Bryce-W-Frazier/rc_over_http/hardware/car.scad

// bearingtest.scad
// Body of the car and it's conponets
// units in mm
// Bryce W. Frazier
// Started: 2026-02-06
// Updated: 2026-02-07

// 606 Bearing
bearing_d = 17;
inner_bearing_d = 6;
bearing_w = 6;

rear_mount_thic = 3;
rear_mount_d = bearing_d+rear_mount_thic;

// Wheel Specs
wheel_d = 35;
wheel_w = 10;
axle_insert = 5;
rim = 3;

// Motor Specs
motor_l = 47;
motor_d = 28;

motor_mount_w = motor_d+2;
motor_strap_w = 13;
motor_strap_gap = 2;

// Steering
steer_bearing_dis = 3;
steer_pin_d = 4;

hub_l = 11.5;
front_axle_stop = 2;
front_axle_l = front_axle_stop+hub_l+1+axle_insert;


// Body Specs
body_w = 80;
body_l = 175;
body_thic = 4;
axel_access = 12;
wheel_lift = 2;

wheel_depth = wheel_lift+rear_mount_d/2;

// PCB Footprint
L298N_hole_dis = 37;
L298N_body_l = 43;

rasbpiB_hole_w_dis = 49;
rasbpiB_hole_l_dis = 58;
rasbpiB_body_w = 56;
rasbpiB_body_l = 85;
rasbpi_screw = 2.5 -2;

pcb_clear = 4;

// Wheels and Axles
module axle(l, d) {
    difference() {
        cylinder(h=l, d=d);
        
        translate([-(d*3)/4, 0, l/2])
            cube([d, d, l], center=true);
    }
}

module frontAxle() {
    translate([-front_axle_l, 0, 0])
    rotate([0, 90, 0]) {
        axle(front_axle_l, inner_bearing_d);
        difference() {
            axle(front_axle_stop, inner_bearing_d+1);
            translate([-inner_bearing_d/2+.5, -inner_bearing_d/2-.5, 0])
                cube([1, inner_bearing_d+1, front_axle_stop]); 
        }
        
    }
}

module wheel() {
    translate([0, 0, wheel_w])
    rotate([180, 0, 0])
    difference() {
        cylinder(h=wheel_w, d=wheel_d);
        cylinder(h=wheel_w-axle_insert, d=wheel_d-rim);
        translate([0, 0, wheel_w-axle_insert])
            axle(axle_insert, inner_bearing_d+1);
    };
}

// Drivetrain
module rearBearingMount() { 
    translate([0, rear_mount_d, -wheel_lift-rear_mount_d/2])
    rotate([90, 0, 90]) {
        difference() {
            union() {
                cylinder(h=bearing_w, d = rear_mount_d);
                
                translate([0, rear_mount_d/2, 0])
                    cylinder(h=bearing_w, d =rear_mount_d*2);
           }
           translate([0, rear_mount_d, bearing_w/2])
                    cube([rear_mount_d*2, rear_mount_d, bearing_w], center=true); 
           cylinder(h=bearing_w, d=bearing_d);
        }
        translate([0, (rear_mount_d + wheel_lift)/2, bearing_w/2])
            cube([rear_mount_d*2, wheel_lift, bearing_w], center=true);
    }
}

module motorMount() {
    translate([0, motor_mount_w/2, motor_mount_w/2])
    rotate([90, 0, 90])
    difference() {
        translate([0, -motor_mount_w/4, motor_l/2])
            cube([motor_mount_w, motor_mount_w/2, motor_l], center=true);
        cylinder(h=motor_l, d=motor_d);
    };
}

module pully(belt_thic, di) {
    wall_thic = 1;
    shell_h = belt_thic+wall_thic*2;
    resses = belt_thic;
    
    difference() {
        cylinder(h=shell_h, d=belt_thic+di);
        translate([0, 0, wall_thic])
        difference() {
            cylinder(h=belt_thic, d=belt_thic+di);
            cylinder(h=belt_thic, d=di);
        }
        
    }
}

module motorPully(){
    difference() {
        pully(3, 30);
        cylinder(5, 2);
    }
}

module axlePully(){
    difference() {
        pully(3, 10);
        axle(5, inner_bearing_d+0.5);
    }
}
// Steering
module steeringWheelMount() {
    dist_from_body = rear_mount_d/2 + wheel_lift;
    
    rod_to_frnt_l = 20;
    
    // Pivot Rod
    difference() {
        union(){
            difference() {
                cylinder(h=body_thic+8, d=inner_bearing_d-1);
                
                translate([0, 0, body_thic+5]) {
                    rotate([0, 90, 0])
                        cylinder(h=inner_bearing_d, d=2);
                    rotate([0, -90, 0])
                        cylinder(h=inner_bearing_d, d=2);
                }
            }    
            translate([0, 0, -dist_from_body]) {
                cylinder(h=dist_from_body, d=inner_bearing_d+1); // Also pivot rod
                
                // Bearing Hub
                rotate([0,-90,0])
                difference() {
                    union() {
                        cylinder(h=hub_l, d=rear_mount_d);
                        translate([0, 0, -inner_bearing_d/2-0.5])
                            cylinder(h=inner_bearing_d+1, d=rear_mount_d);
                    }
                    translate([0, 0, hub_l-bearing_w]) {
                        cylinder(h=bearing_w, d=bearing_d);
                    }
                };
                
                // Secondary Tie Rod
                rotate([-90,0,0])
                    cylinder(h=rod_to_frnt_l, d=6);
                translate([0,rod_to_frnt_l,0]) {
                    sphere(d=6);
                    cylinder(h=10, d=steer_pin_d);
                }
            }
        }
        // Axle Access
        translate([0, 0, -dist_from_body])
        rotate([0, 90,0])
        translate([0, 0, -(hub_l-bearing_w)])
            cylinder(h=rod_to_frnt_l, d=(bearing_d+inner_bearing_d)/2);
    }
}

module priTieRod() {
    hole_d = steer_pin_d+1;
    hole_spaceing = steer_pin_d+2;
    rod_l = body_w-rear_mount_d+steer_pin_d+steer_bearing_dis/2;
    
    rotate([0, -90, 0])
    difference() {
        axle(rod_l, hole_spaceing);
        rotate([0, 90, 0]) {
            translate([-(steer_pin_d/2+2), 0, -inner_bearing_d/2])
                cylinder(h=inner_bearing_d, d=hole_d);
            translate([-rod_l+(steer_pin_d/2+2), 0, -inner_bearing_d/2])
                cylinder(h=inner_bearing_d, d=hole_d);
        }
    }
}

//PCB Footprint
module screwMount(s_h, s_d) {
    difference() {
        cylinder(h=s_h, d=s_d+1.5);
        cylinder(h=s_h, d=s_d);
    }
}
module rasbpi() {
   screwMount(pcb_clear, rasbpi_screw);
   translate([rasbpiB_hole_w_dis, 0, 0])
        screwMount(pcb_clear, rasbpi_screw);
   translate([0, rasbpiB_hole_l_dis, 0]) {
        screwMount(pcb_clear, rasbpi_screw);
        translate([rasbpiB_hole_w_dis, 0, 0])
            screwMount(pcb_clear, rasbpi_screw);
    }
}

module L298N() {
    screwMount(pcb_clear, rasbpi_screw);
   translate([L298N_hole_dis, 0, 0])
        screwMount(pcb_clear, rasbpi_screw);
   translate([0, L298N_hole_dis, 0]) {
        screwMount(pcb_clear, rasbpi_screw);
        translate([L298N_hole_dis, 0, 0])
            screwMount(pcb_clear, rasbpi_screw);
    }
}
// Overall Car
module steeringMountAndWheel() {
    steeringWheelMount();
    
    rotate([0, 0, 180])
    translate([(hub_l-bearing_w+front_axle_l-front_axle_stop), 0, -wheel_lift-rear_mount_d/2])
        frontAxle();
    
    rotate([0, -90, 0])
    translate([-wheel_depth, 0, hub_l+1])
    rotate([0, 0, 180])
        wheel();
}
module mainBody() {
    // Servo Specs 
    // Tower Pro SG90
    servo_w       = 23;
    servo_tab     =  5;
    servo_h       = 12;
    servo_mount_l = 15;
    servo_mount_screw = 2;
    
    //Steering clearance
    steering_cutout_angle = 50;

    difference(){
        union() {
            cube([body_w, body_l, body_thic], center=false);
            
    // Drive Train ################################################
            // Axle Mount
            rearBearingMount();
            translate([body_w - bearing_w, 0, 0]) rearBearingMount();
        }
    // Access of Axle for Beltdrive
    translate([bearing_w, rear_mount_d/4, 0]) 
        cube([axel_access, (rear_mount_d*3)/2, body_thic]);
    
    // Motor Straps
    translate(
    [bearing_w + axel_access + motor_l/8, rear_mount_d/4 - motor_strap_gap, 0])
        cube([motor_strap_w, motor_strap_gap, body_thic]);    
    translate(
    [bearing_w + axel_access + 7*motor_l/8, rear_mount_d/4 - motor_strap_gap, 0])
        cube([motor_strap_w, motor_strap_gap, body_thic]);   
    translate(
    [bearing_w + axel_access + motor_l/8, rear_mount_d/4 + (rear_mount_d*3)/2, 0])
        cube([motor_strap_w, motor_strap_gap, body_thic]);    
    translate(
    [bearing_w + axel_access + 7*motor_l/8, rear_mount_d/4 + (rear_mount_d*3)/2, 0])
        cube([motor_strap_w, motor_strap_gap, body_thic]); 
        
    // Steering ###################################################
    // Body cutout of steering clearance
    translate(
    [bearing_d/4+steer_bearing_dis, 
    body_l - bearing_d/2-steer_bearing_dis, 
    0])
        cube(
        [rear_mount_d/2+steer_bearing_dis*2, 
        rear_mount_d+steer_bearing_dis, 
        body_thic*2], 
        center=true);
    translate([body_w-(bearing_d/4+steer_bearing_dis), 
    (body_l - bearing_d/2-steer_bearing_dis), 
    0])
        cube(
        [rear_mount_d/2+steer_bearing_dis*2, 
        rear_mount_d+steer_bearing_dis, 
        body_thic*2], 
        center=true);
    
    translate([rear_mount_d, body_l -rear_mount_d-steer_bearing_dis, 0])
    rotate([0, 0, 90+steering_cutout_angle])
        cube([body_l, body_l, body_thic]);
    translate([body_w-rear_mount_d, body_l -rear_mount_d-steer_bearing_dis, 0])
    rotate([0, 0, -steering_cutout_angle])
        cube([body_l, body_l, body_thic]);


    // Bearing Holes
    translate([bearing_d/2+steer_bearing_dis, body_l - bearing_d/2-steer_bearing_dis, 0])
        cylinder(h=bearing_w, d=bearing_d);
    translate([body_w-(bearing_d/2+steer_bearing_dis), body_l - (bearing_d/2+steer_bearing_dis), 0])
        cylinder(h=bearing_w, d=bearing_d);      
    
    } // End of difference()
    
    translate([bearing_d/2+steer_bearing_dis, body_l - (bearing_d/2+steer_bearing_dis), 0])
    difference() {
        cylinder(h=bearing_w, d=bearing_d+3);
        cylinder(h=bearing_w, d=bearing_d);
    };
    translate([body_w-(bearing_d/2+steer_bearing_dis), body_l - (bearing_d/2+steer_bearing_dis), 0])
    difference() {
        cylinder(h=bearing_w, d=bearing_d+3);
        cylinder(h=bearing_w, d=bearing_d);
    };
    
    translate([bearing_d/2+steer_bearing_dis, body_l- bearing_d/2-steer_bearing_dis, bearing_w])
        difference() {
            cylinder(h=2, d=bearing_d+3);
            cylinder(h=2, d=(inner_bearing_d+bearing_d)/2);
        }
    translate([body_w-(bearing_d/2+steer_bearing_dis), body_l- bearing_d/2-steer_bearing_dis, bearing_w])
        difference() {
            cylinder(h=2, d=bearing_d+3);
            cylinder(h=2, d=(inner_bearing_d+bearing_d)/2);
        }
        
    // Servo Mount
    translate([body_w/2, body_l-servo_mount_l/2, servo_h/2+body_thic])
    difference() {
        cube([servo_w+servo_tab*2, servo_mount_l, servo_h], center=true);
        cube([servo_w, servo_mount_l, servo_h], center=true);
        rotate([-90, 0, 0]) {
            translate([(servo_w+servo_tab)/2, 0, -servo_mount_l/2])
                cylinder(h=servo_mount_l*2, d=servo_mount_screw);
            translate([-(servo_w+servo_tab)/2, 0, -servo_mount_l/2])
                cylinder(h=servo_mount_l*2, d=servo_mount_screw);
        }
    }
}

module wholeCar () {
    demo_steer_angle = 0;
    
    mainBody();
    
    // Powertrain
    translate([bearing_w + axel_access + motor_l/8, rear_mount_d/4, body_thic])
        motorMount();
    
    translate([-axle_insert*2-1, rear_mount_d, -wheel_depth])
    rotate([0, 90, 0])
        axle(body_w+axle_insert*4+2, inner_bearing_d);
    translate([-1, rear_mount_d, -wheel_depth])
    rotate([0, -90, 0])
    rotate([0, 0, 180])
        wheel();
    translate([body_w+1, rear_mount_d, -wheel_depth])
    rotate([0, 90, 0])
        wheel();
    
    // Steering
    translate([bearing_d/2+3, body_l- bearing_d/2-3, 0])
    rotate([0, 0, demo_steer_angle])
        steeringMountAndWheel();
    translate([body_w-(bearing_d/2+3), body_l- bearing_d/2-3, 0])
    mirror([1, 0, 0])
    rotate([0, 0, -demo_steer_angle])
        steeringMountAndWheel();
       
    translate(
    [body_w - rear_mount_d/2 + steer_bearing_dis, 
    body_l+8.5, 
    -wheel_depth+inner_bearing_d/2+1])
        priTieRod();
        
    translate(
    [rasbpiB_body_w-rasbpiB_hole_w_dis, 
    rear_mount_d*2+rasbpiB_body_w+1, 
    body_thic])
    rotate([0, 0, -90])
        rasbpi();
}



//wholeCar();

/*
rotate([0, 90, 0])
translate([-inner_bearing_d/2-0.5, 0, 0])
mirror([0, 1, 0])
    steeringWheelMount();
translate([0, 40, 1.5])
rotate([0,180, 0])
    frontAxle();
translate([0, -50, 0])
translate([0, 0, 0])
    wheel();

translate([25, 0, 0])
rotate([0,0,90])
priTieRod();
*/
motorPully();
translate([40, 0, 0])
    axlePully();
translate([0, 40, 0])
    wheel();
translate([0, 80, 0])
    wheel();
translate([-20, 0, 0])
    axle(body_w+axle_insert*4+2, inner_bearing_d);
translate([0, -80, 0])
    motorMount();
