Bryce-W-Frazier/rc_over_http/(commit log)

2026-02-01 Added servo Function
2026-02-01 Impelmented Steering Mockup
2026-02-01 npm: add package socket.io, removed onoff
2026-02-01 socket.io: prof of consept
2026-02-02 Client now uses steering vector
2026-02-02 now goes straight, when no steering input
2026-02-02 Steering improved
2026-02-02 Added throttle
2026-02-08 hardware: Started Car, set up drivetrain
    [car.scad]
2026-02-08 hardware: added steering bearings
    [car.scad]
2026-02-08 hardware: added wholeCar module
    [car.scad]
2026-02-08 hardware: lifted stearing mount bearings
    [car.scad]
2026-02-08 hardare: add wheel lift
    [car.scad]
2026-02-08 hardare: SteeringWheelMount fully implemnted
    [car.scad]
2026-02-08 doc: Improved comments.
    [car.scad]
2026-02-08 hardware: implemented servo mount
    [car.scad]
2026-02-08 fix: Screw holes full length for servo mount
    [car.scad]
2026-02-08 hardware: Working on wheel, moded axle
    [car.scad]
2026-02-08 hardware: Implemented basic wheel.
    [car.scad]
2026-02-08 hardware: Implemented front wheels on Model
    [car.scad]
2026-02-08 hardware: Rendered rear wheels and axle.
    [car.scad]
2026-04-28 hardware: adjusted tolerances on wheel and steeringWheelMount
    [car.scad]
2026-04-28 working on steerig
    [car.scad]
2026-04-28 hardware: improved steering mount and axle for printing
    [car.scad]
2026-04-28 Added cutouts in body for steering clearance
    [car.scad]
2026-04-28 hardware: added primary tie rod
    [car.scad]
2026-04-28 hardware: added pdb modules
    [car.scad]
2026-04-28 feat: cadlisting of all parts
    [car.scad]
